Surjune/Lightning-Logics-Hardware/(commit log)

2026-09-27 Add repository scaffold and sonarscope package skeleton
2026-09-27 Add reconstruction filter model and transmit-chain simulator with fault injection
2026-09-27 Add pass/fail criteria, bench test plan and per-test analysis with verdicts
    [analyze.py, plan.py, thresholds.py]
2026-09-27 Add benches and instrument drivers: simulated, file replay, Rigol/Siglent SCPI, Analog Discovery, DUT link
2026-09-27 Add self-check with fault-injection discrimination and the sonarscope command line
2026-09-29 Add ESP32 transmitter firmware with DMA-fed DAC and pot-driven adaptation
    Arduino sketch (esp32 core 3.x) for the PS 26058 transmitter:
    - dac_continuous (I2S0 -> built-in DAC, GPIO25) at 2 MSPS, fed by a DMA ring
    that a core-0 task refills; double-buffered pulses swap at ping boundaries
    - DDS synthesis of LFM, geometric, Barker-13 and CW pulses with rect/Tukey/
    Hann/Hamming/Blackman windows, matching sonarscope.waveforms.dac_codes()
    - demo mode: turbidity/reach pots set band, pulse length and amplitude;
    BOOT button cycles modulation and window; T0 marker on GPIO27
    - serial test-mode protocol (CFG/NEXT/PRI/RUN/IDLE) plus PRESET, STATUS,
    DUMP; tools/check_codes.py compares on-target co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
    [check_codes.py, config.h, dac_stream.cpp, dac_stream.h, dut.py, pulse.cpp, pulse.h, sonar_tx.ino]
2026-09-29 Add analog front end: schematic, BOM, netlist and bring-up guide
    One quad rail-to-rail op-amp on the ESP32's 5 V pin: a buffer for the DAC
    pin, a 4th-order Butterworth low-pass at 600 kHz from two Sallen-Key stages,
    and an AC-coupled driver with gain 1.51 into a 1 kOhm dummy load.
    - schematic.svg, generated by tools/make_schematic.py
    - bom.csv with E24 substitutes, checked against the sonarscope filter model
    - README: op-amp choice (OPA4350; MCP6294 for breadboards), pin-by-pin
    netlist, build order and bring-up steps with expected readings
    - scope README: TP2 described as the buffer output
    [bom.csv]
2026-09-29 Add physics-based adaptation, telemetry and a live dashboard
    Firmware:
    - env_model: Mackenzie sound speed, Francois-Garrison seawater absorption
    and a suspended-sediment term pick the highest band the water allows for
    the required range, then pulse length, amplitude, window, modulation
    (LFM, or Barker-13 at short range) and ping interval
    - five environment inputs (turbidity, range, temperature, salinity, depth)
    from pots or the ENV command; MOD and WIN force modulation and window
    - TELEM ON streams @{json} status with the pulse at full precision
    Validation:
    - sonarscope.acoustics is the reference model, with unit tests
    - tools/check_adaptation.py: 105 of 105 board decisions match it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
    [acoustics.py, check_adaptation.py, config.h, env_model.cpp, env_model.h, sonar_tx.ino]
2026-09-29 Rewrite the README as a guide for new readers
    Plain-language explanation of the problem and the design, a table mapping
    each problem-statement requirement to its file, a step-by-step build
    (firmware, pots, oscilloscope, dashboard, filter board, check tools) with
    what the scope should show, measured results, troubleshooting, a glossary
    and references. Install commands now use ./scope so pip treats it as a path.
2026-09-30 Default to one pot and list the enabled pots at boot
    The bench setup has a single potentiometer, on G34 (turbidity). With
    RANGE_POT_WIRED on, the unconnected G35 pin floated and pinned the range
    near 5 m. Range is now off by default and stays at 60 m unless it is set
    with ENV or a second pot is enabled. The boot log names only the pots
    that config.h enables, and the READMEs and BOM mark the range pot as
    optional.
    [bom.csv]
2026-10-01 Rewrite the README as an evaluator's guide with oscilloscope evidence
    Lead with the measured result (416.7 kHz clear vs 104.2 kHz muddy on a
    Hantek DSO2C10), then the problem, the four-module solution, a
    requirement-by-requirement checklist with evidence and status, the
    oscilloscope captures and the board's own decision log, how it works,
    the STM32 target / ESP32 prototype split, and a tested demo procedure.
    Add docs/images/: the bench setup, five scope captures and the wiring
    diagram.
2026-10-01 Describe the project without event or problem-statement references
    [config.py, sonar_tx.ino, thresholds.py]
